majanoff/NTP-Meter-Clock/meterclock ntp.jpg

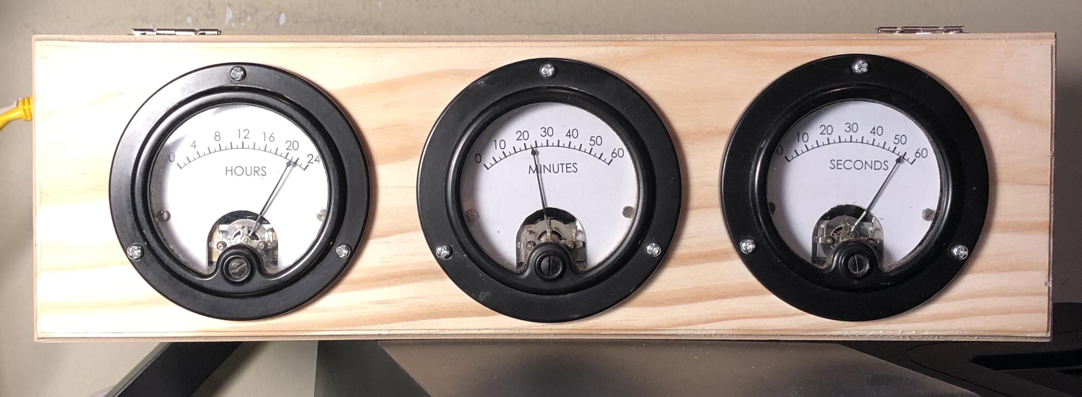
meterclock ntp.jpg
