majanoff/NTP-Meter-Clock/hours 0-24 weston 301.pdf

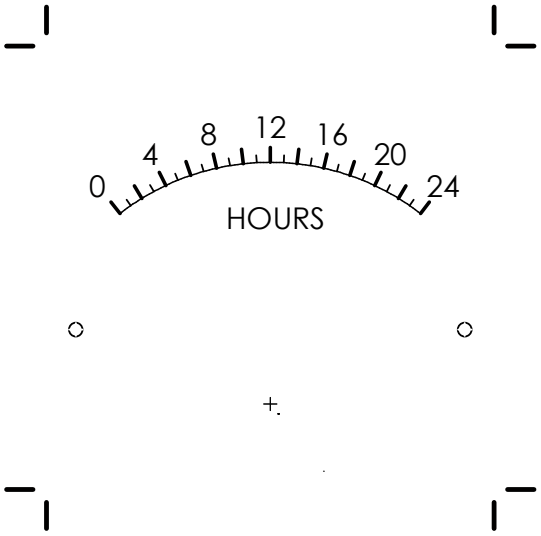
[picture p2: figure]
HOURS

Printed by Meter from Tonne Software 2/16/2019 9:02:00 AM www.TonneSoftware.com
C:\Users\mj-hp-desktop\Desktop\weston hour 301 11-12-2017 v1.MTR
