majanoff/NTP-Meter-Clock/minutes 0-60 weston 301.pdf

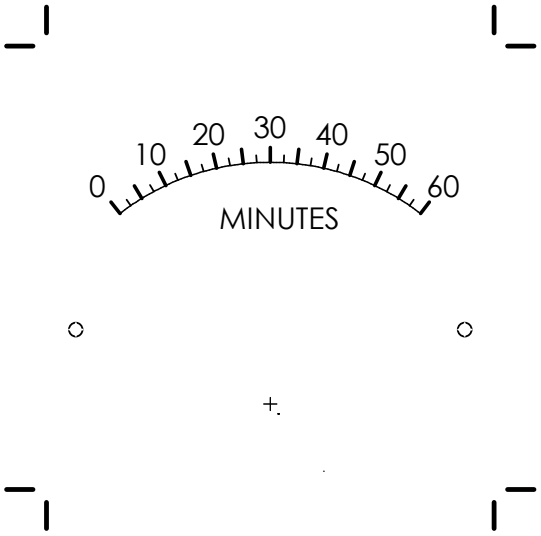
[picture p3: figure]
MINUTES

Printed by Meter from Tonne Software 2/16/2019 9:05:14 AM www.TonneSoftware.com
C:\Program Files\Meter\weston minute 301 11-12-2017 v1.MTR
