majanoff/NTP-Meter-Clock/seconds 0-60 weston 301.pdf

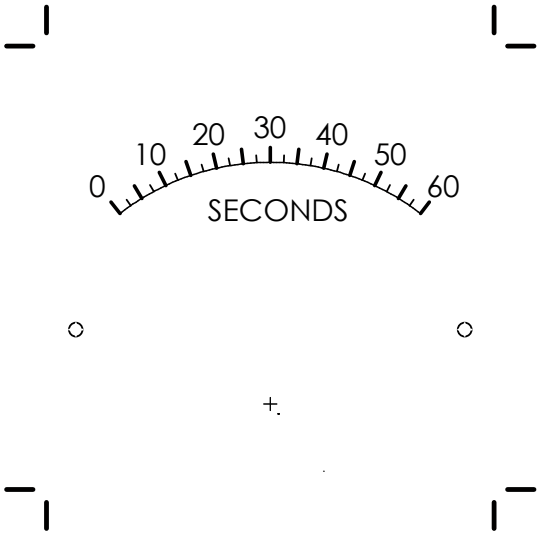
[picture p4: figure]
SECONDS

Printed by Meter from Tonne Software 2/16/2019 9:04:24 AM www.TonneSoftware.com
C:\Program Files\Meter\weston seconds 301 11-12-2017 v1.MTR
