majanoff/NTP-Meter-Clock/schematic.jpg

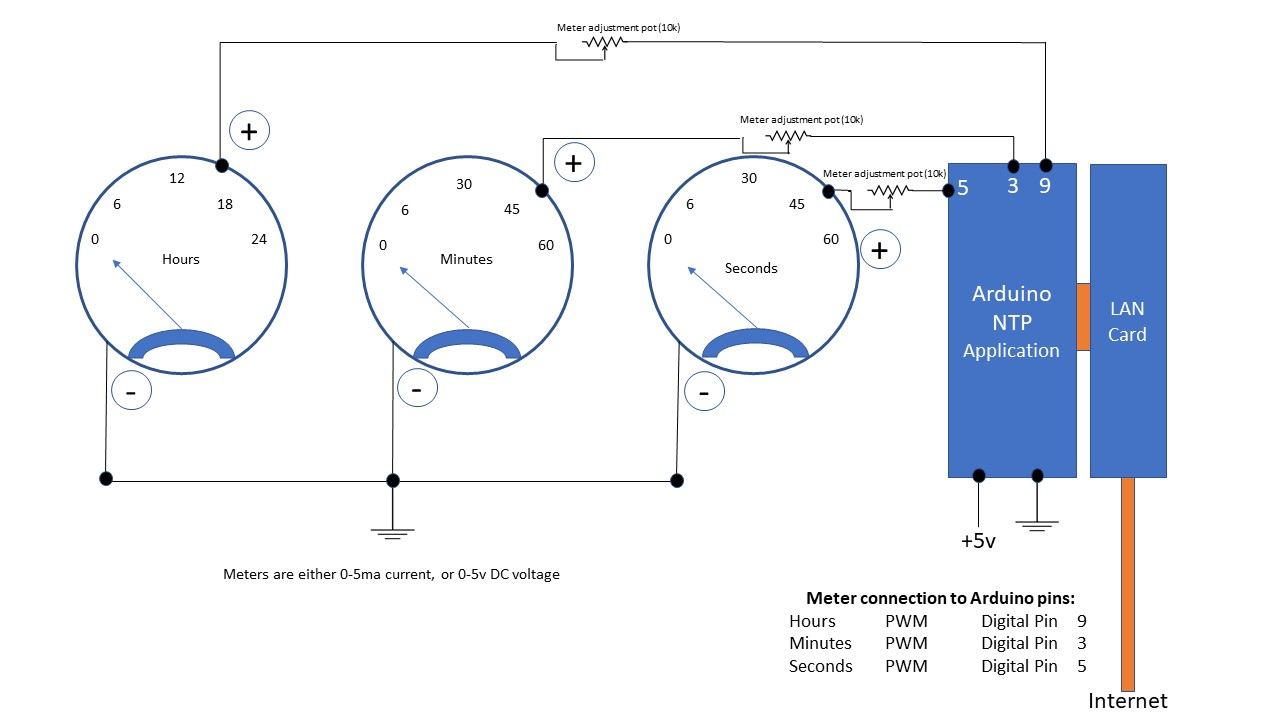
schematic.jpg
